theblinkingman/plant-waterer/README.md

# plant-waterer
TDR sensor to water a plant automatically

See https://hackaday.io/project/193184-tdr-soil-moisture-sensor for more details
