theblinkingman/plant-waterer/plant_waterer/plant_waterer.pdf

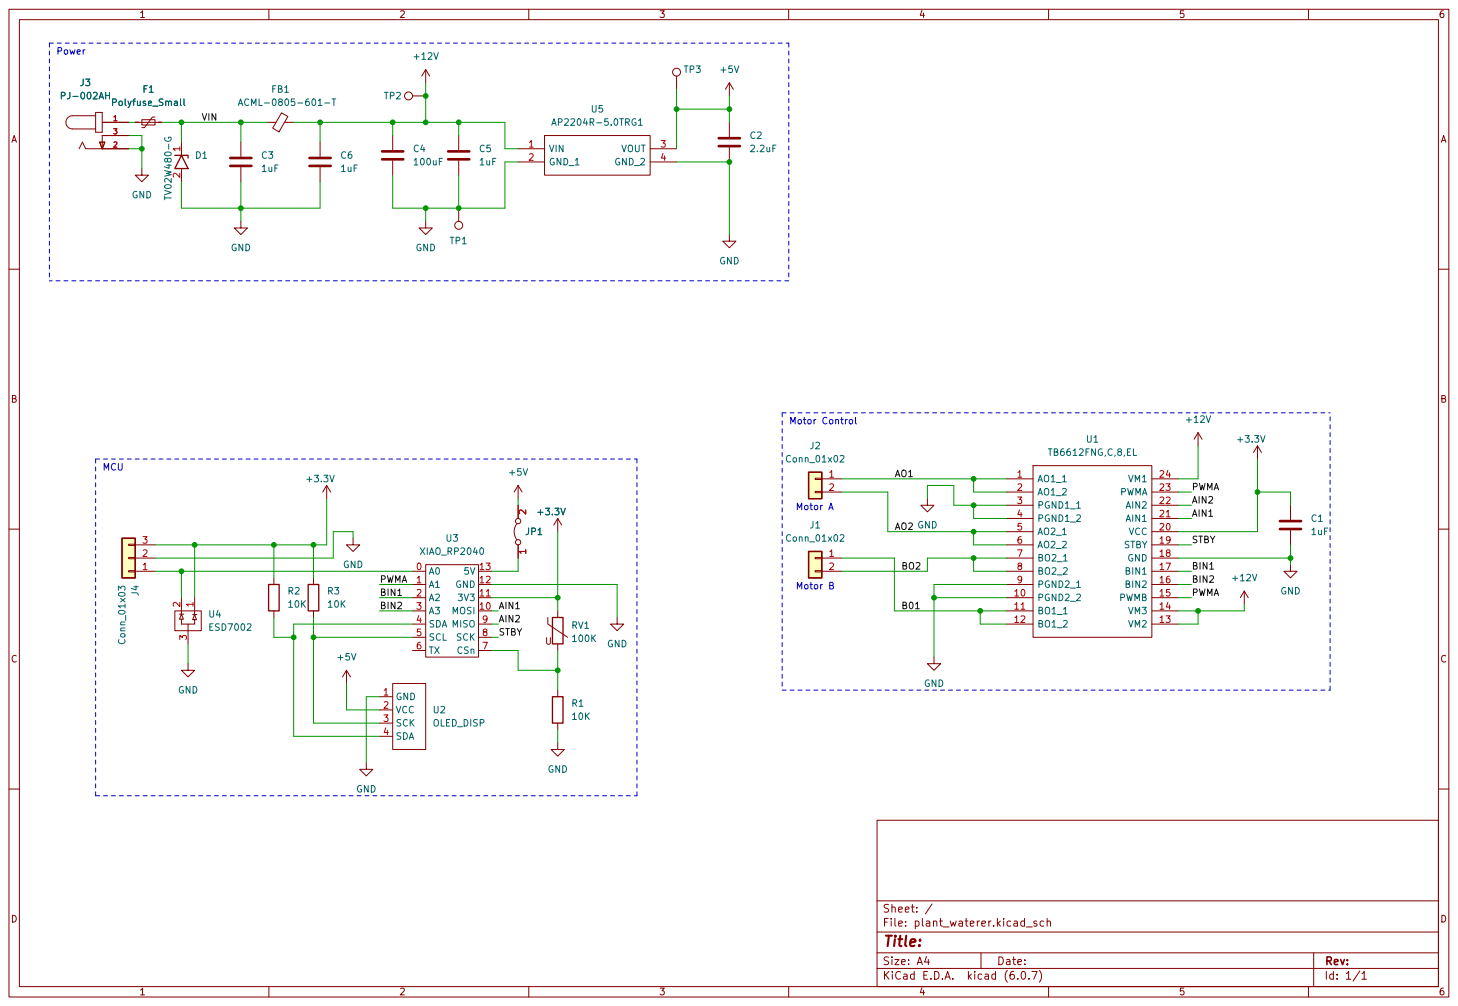
[picture p1: page 1]
