theblinkingman/plant-waterer/plant_combined/plant_combined.kicad_pcb

## KiCad design plant_combined/plant_combined.kicad_pcb (2023-11-19)

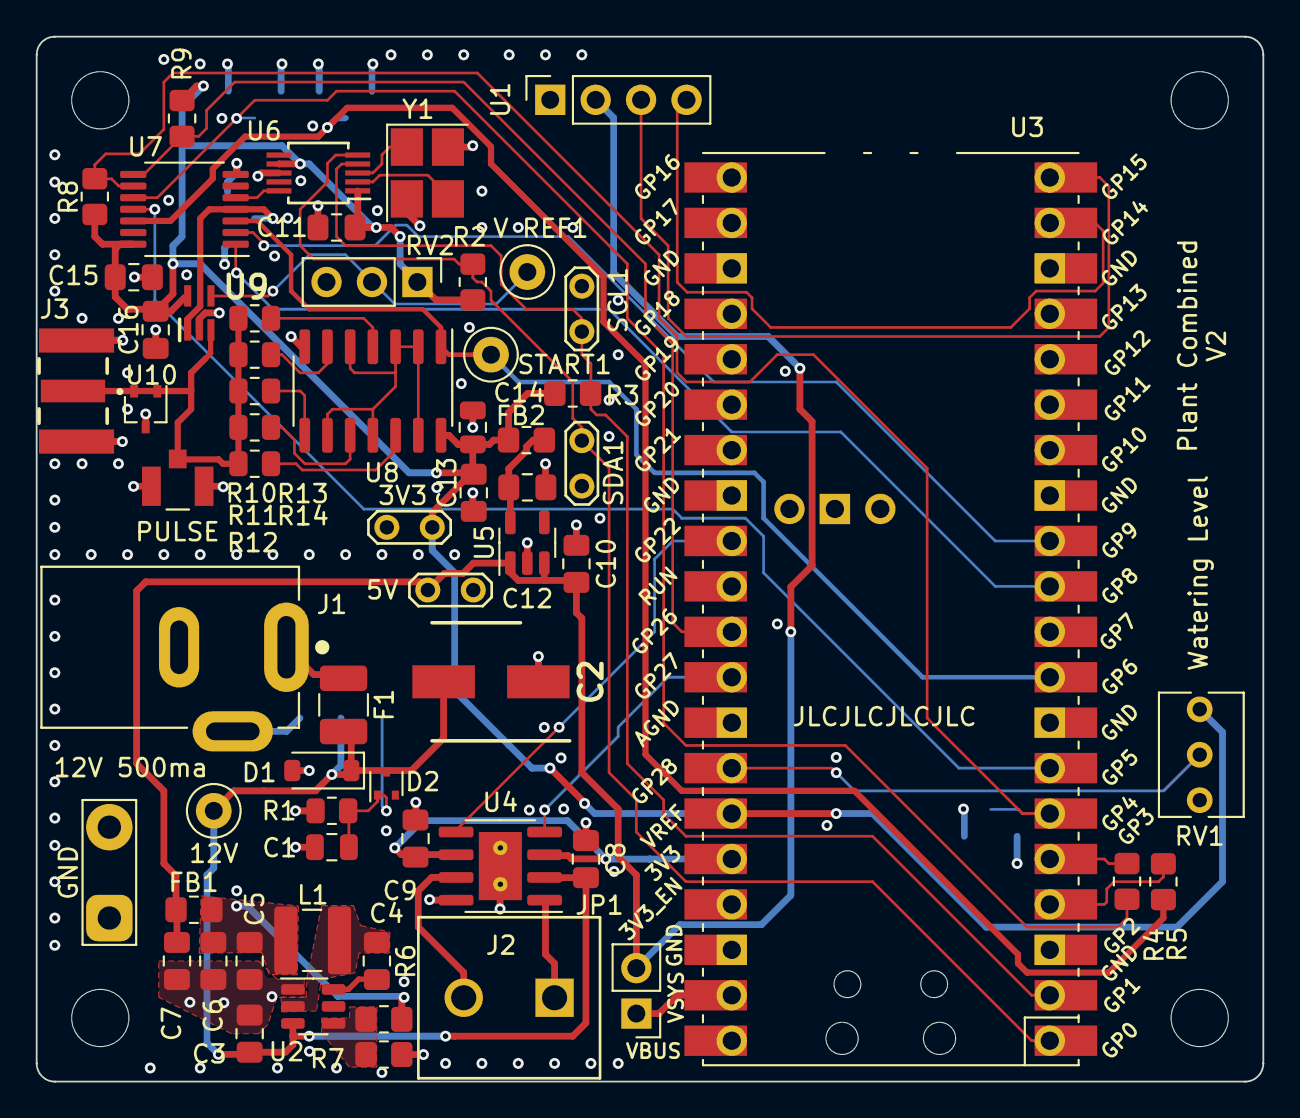
[picture p2: board plant_combined.kicad_pcb from above]

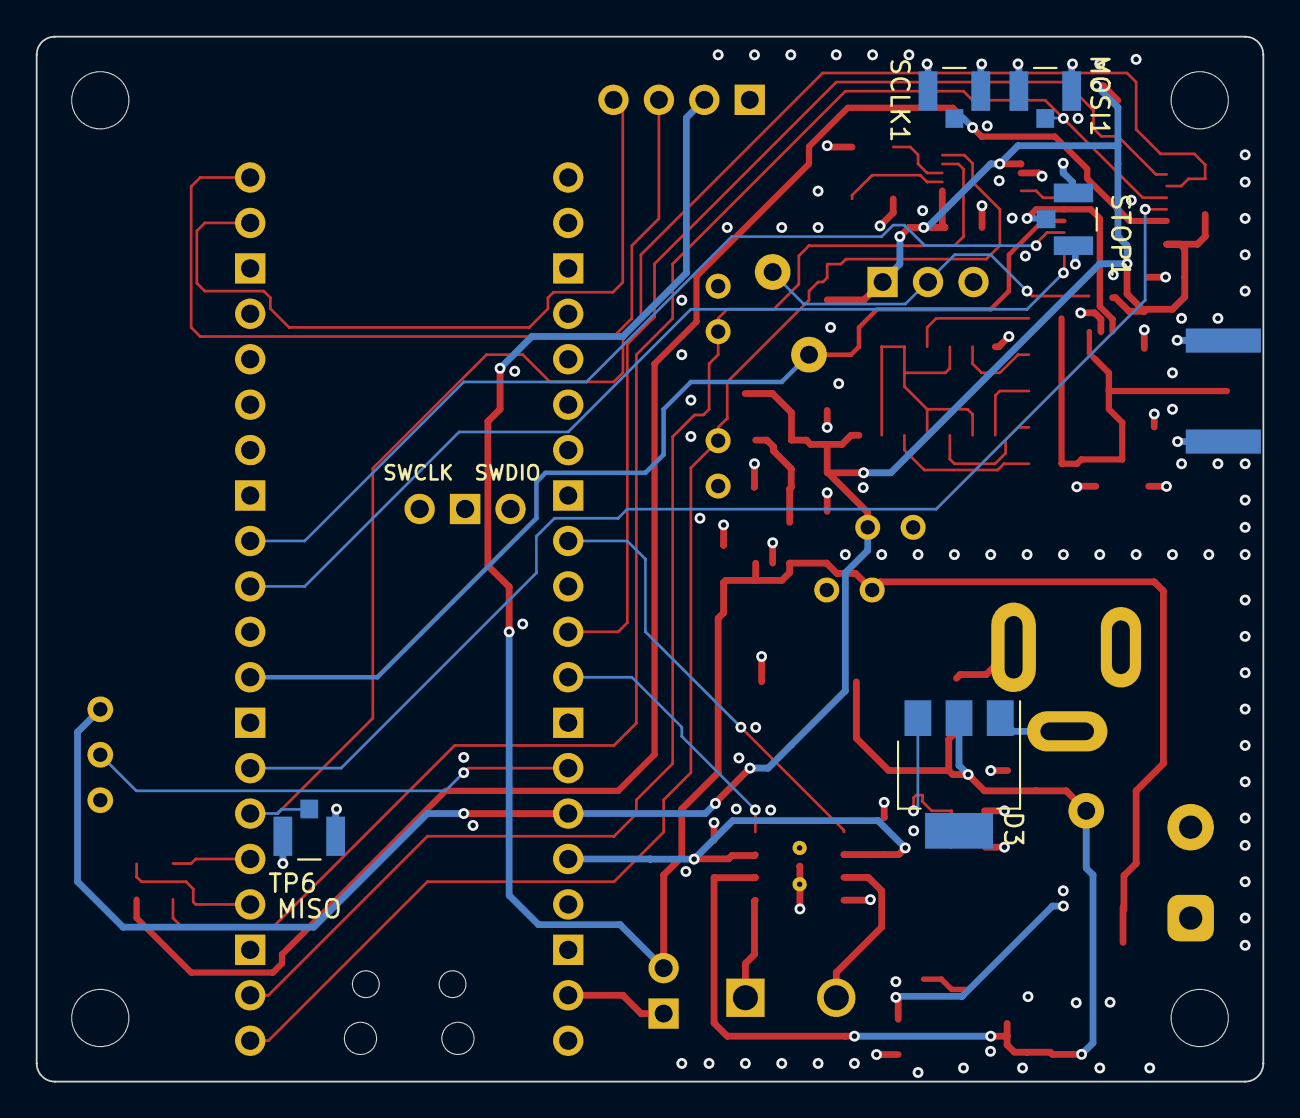
[picture p3: board plant_combined.kicad_pcb from below]

Board: 4 copper layers, 68.6 x 58.4 mm, 67 parts (5 on the bottom side), 44 nets.

Parts:
C1: 10nf; C_0805_2012Metric
C2: 100uF; UUA1C101MCL1GS
C3, C8: 10uF; C_0805_2012Metric_Pad1.18x1.45mm_HandSolder
C4: 100nF; C_0805_2012Metric_Pad1.18x1.45mm_HandSolder
C5: 22uF; C_0805_2012Metric_Pad1.18x1.45mm_HandSolder
C6, C7, C9, C10, C11, C12, C13, C15, C16: 1uF; C_0805_2012Metric_Pad1.18x1.45mm_HandSolder
C14: 1uF; C_0805_2012Metric
D1: TV02W480-G; D_SOD-123
D2: BZX84Cxx; SOT-523
D3: BT168GW; SOT-223
F1: 500ma; Fuse_1210_3225Metric_Pad1.42x2.65mm_HandSolder
FB1, FB2: ACML-0805-601-T; R_0805_2012Metric_Pad1.20x1.40mm_HandSolder
J1: PJ-002AH; CUI_PJ-002AH
J2: Conn_01x02; CONN 1x2 5mm
J3: SMA-J-P-H-ST-EM1; SAMTEC_SMA-J-P-H-ST-EM1
JP1: Jumper_2_Bridged; PinHeader_1x02_P2.54mm_Vertical
L1: 4.7uH; SDCL1V4020
MOSI1: TestPoint; HIROSE_U.FL-R-SMT-1(01)
R1: 68; R_0805_2012Metric
R2, R3: 4K7; R_0805_2012Metric_Pad1.20x1.40mm_HandSolder
R4, R5: 82; R_0805_2012Metric_Pad1.20x1.40mm_HandSolder
R6: 52K3; R_0805_2012Metric_Pad1.20x1.40mm_HandSolder
R7, R9: 10K; R_0805_2012Metric_Pad1.20x1.40mm_HandSolder
R8: 1K; R_0805_2012Metric_Pad1.20x1.40mm_HandSolder
R10, R11, R12, R13, R14: 249; R_0805_2012Metric
RV1: R_Potentiometer; Potentiometer_Bourns_3266Y_Vertical
RV2: 10K; PinHeader_1x03_P2.54mm_Vertical
SCL1: TestPoint_2Pole; TestPoint_2Pads_Pitch2.54mm_Drill1mm
SCLK1: TestPoint; HIROSE_U.FL-R-SMT-1(01)
SDA1: TestPoint_2Pole; TestPoint_2Pads_Pitch2.54mm_Drill1mm
START1: TestPoint; TestPoint_Loop_D1.80mm_Drill1.0mm_Beaded
STOP1: TestPoint; HIROSE_U.FL-R-SMT-1(01)
TP1: TestPoint; TestPoint_Loop_D1.80mm_Drill1.0mm_Beaded
TP1#2, TP6: TestPoint; HIROSE_U.FL-R-SMT-1(01)
TP2: TestPoint_2Pole; TestPoint_2Pads_Pitch5.08mm_Drill1.3mm
TP3: TestPoint; TestPoint_2Pads_Pitch2.54mm_Drill1mm
TP4: TestPoint_2Pole; TestPoint_2Pads_Pitch2.54mm_Drill1mm
U1: OLED_DISP; PinSocket_1x04_P2.54mm_Vertical
U2: AP62200WU-7; SOT-23-6
U3: PicoW; RPi_PicoW_SMD_TH
U4: ZXBM5210-SP-13; SOIC-8-1EP_3.9x4.9mm_P1.27mm_EP2.41x3.81mm
U5: MCP1700T; TSOT-23-5
U6: SI5351A-B-GT; MSOP-10_3x3mm_P0.5mm
U7: TDC7200PWR; TSSOP-14_4.4x5mm_P0.65mm
U8: 74AC14SC; SOIC-14_3.9x8.7mm_P1.27mm
U9: ADCMP600BKSZ-R2; SOT65P210X110-5N
U10: ESD7002; SOT-323_SC-70
V REF1: TestPoint; TestPoint_Loop_D1.80mm_Drill1.0mm_Beaded
Y1: Crystal_GND24; Crystal_SMD_3225-4Pin_3.2x2.5mm_HandSoldering

Connections:
+3.3V: C9.2, U3.36 (3V3), U4.3 (VDD), U4.6 (VREF)
+3.3VA: C11.2, C13.2, C14.1, C15.2, C16.2, FB2.2, R2.1, R3.1, R8.2, R9.2, RV1.1, RV2.1, TP4.2, U3.35 (ADC_VREF), U6.1 (VDD), U6.7 (VDDO), U7.14 (VDD), U8.14 (VCC), U9.5 (VCC_I/O)
+5V: C7.2, C10.2, FB1.2, JP1.2 (B), TP3.2, U1.2 (VCC), U5.1 (IN), U5.3 (EN)
+12P: C2.2, C3.2, C8.2, D1.1, D2.3 (K), D3.2 (A), F1.2, TP1.1, U2.3 (VIN), U4.2 (VM)
/5V_JUMP: JP1.1 (A), U3.39 (VSYS)
/5V_UNFILT: C5.2, C6.2, FB1.1, L1.2, R6.1
/AIN1: U3.32 (GPIO27_ADC1), U4.4 (FWD)
/AIN2: U3.29 (GPIO22), U4.5 (REV)
/AO1: J2.1, U4.1 (OUT_1)
/AO2: J2.2, U4.7 (OUT_2)
/FB: R6.2, R7.1, U2.4 (FB)
/SW: C4.1, L1.1, U2.2 (SW)
/VIN: F1.1, J1.1
/tdr_sensor/+3_UNFILTERED: C12.2, FB2.1, U5.5 (OUT)
/tdr_sensor/CLK: U6.10 (CLK0), U7.5 (CLOCK)
/tdr_sensor/PULSE: J3.1, R10.2, R11.2, R12.2, R13.2, R14.2, TP1#2.1, U9.3 (VP), U10.1, U10.2
/tdr_sensor/STOP: STOP1.1, U7.4 (STOP), U9.1 (Q)
/tdr_sensor/V ref: RV2.2, U9.4 (VN), V REF1.1
EN: U3.11 (GPIO8), U7.1 (ENABLE)
GND: C1.2, C2.1, C3.1, C5.1, C6.1, C7.1, C8.1, C9.1, C10.1, C11.1, C12.1, C13.1, C14.2, C15.1, C16.1, D1.2, D3.1 (K), J1.2, J1.3, J3.2_1, J3.2_2, J3.3_1, J3.3_2, MOSI1.2, R1.1, R7.2, RV1.3, RV2.3, SCL1.2, SCLK1.2, SDA1.1, STOP1.2, TP1#2.2, TP2.1, TP2.2, TP3.1, TP4.1, TP6.2, U1.1 (GND), U2.1 (GND), U3.3 (GND), U3.8 (GND), U3.13 (GND), U3.18 (GND), U3.23 (GND), U3.28 (GND), U3.33 (AGND), U3.38 (GND), U4.8 (GND), U4.9 (EP), U5.2 (GND), U6.8 (GND), U7.7 (GND), U8.7 (GND), U9.2 (GND), U10.3, Y1.2, Y1.4
INTB: R9.1, U3.31 (GPIO26_ADC0), U7.8 (INTB)
MISO: R8.1, TP6.1, U3.6 (GPIO4), U7.9 (DOUT)
MOSI: MOSI1.1, R4.2, U7.10 (DIN)
unnamed: C1.1, D2.1 (A), D3.3 (G), R1.2
unnamed: U1.3 (SCK), U3.20 (GPIO15)
unnamed: U1.4 (SDA), U3.19 (GPIO14)
unnamed: C4.2, U2.6 (BST)
unnamed: R5.1, U3.4 (GPIO2)
unnamed: R4.1, U3.5 (GPIO3)
unnamed: RV1.2, U3.34 (GPIO28_ADC2)
unnamed: U6.2 (XA), Y1.3
unnamed: U6.3 (XB), Y1.1
unnamed: U8.2 (O0), U8.3 (I1), U8.5 (I2), U8.9 (I3), U8.11 (I4), U8.13 (I5)
unnamed: R10.1, U8.4 (O1)
unnamed: R11.1, U8.6 (O2)
unnamed: R12.1, U8.8 (O3)
unnamed: R13.1, U8.10 (O4)
unnamed: R14.1, U8.12 (O5)
SCL: R3.2, SCL1.1, U3.2 (GPIO1), U6.4 (SCL)
SCLK: R5.2, SCLK1.1, U7.12 (SCLK)
SDA: R2.2, SDA1.2, U3.1 (GPIO0), U6.5 (SDA)
START: START1.1, U3.9 (GPIO6), U7.3 (START), U8.1 (I0)
TDC CSB: U3.7 (GPIO5), U7.11 (CSB)
TRIG: U3.12 (GPIO9), U7.2 (TRIGG)
