theblinkingman/plant-waterer/plant_waterer/plant_waterer.kicad_pcb

## KiCad design plant_waterer/plant_waterer.kicad_pcb (2023-04-02)

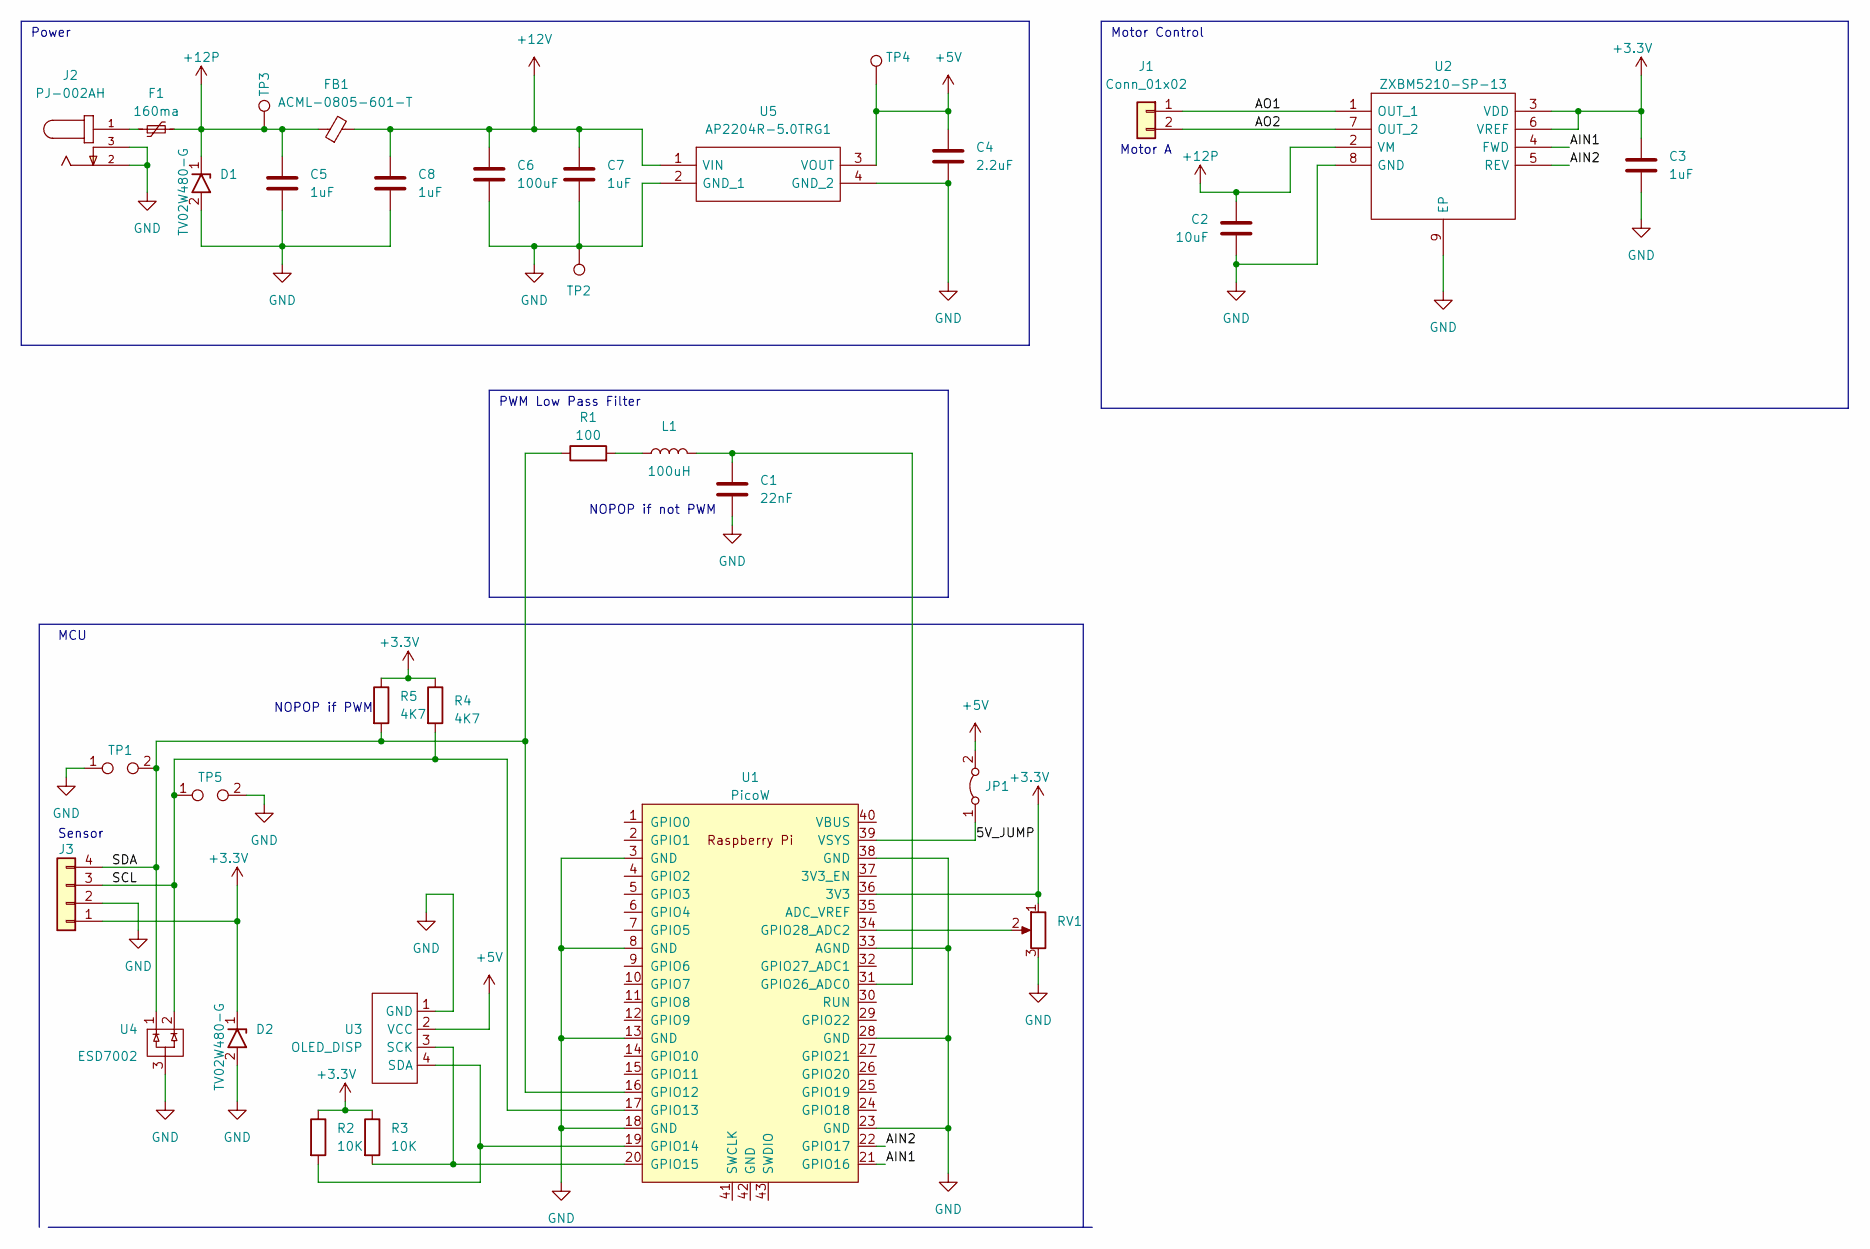
[picture p4: schematic plant_waterer.kicad_sch]

Parts:
C1: 22nF; C_0805_2012Metric_Pad1.18x1.45mm_HandSolder
C2: 10uF; C_0805_2012Metric_Pad1.18x1.45mm_HandSolder
C3, C5, C7, C8: 1uF; C_0805_2012Metric_Pad1.18x1.45mm_HandSolder
C4: 2.2uF; C_0805_2012Metric_Pad1.18x1.45mm_HandSolder
C6: 100uF; UUA1C101MCL1GS
D1, D2: TV02W480-G; D_SOD-123
F1: 160ma; Fuse_1210_3225Metric_Pad1.42x2.65mm_HandSolder
FB1: ACML-0805-601-T; R_0805_2012Metric_Pad1.20x1.40mm_HandSolder
J1: Conn_01x02; CONN 1x2 5mm
J2: PJ-002AH; CUI_PJ-002AH
J3: Conn_01x03; PinSocket_1x04_P2.54mm_Vertical
JP1: Jumper_2_Bridged; PinHeader_1x02_P2.54mm_Vertical
L1: 100uH; L_0805_2012Metric_Pad1.05x1.20mm_HandSolder
R1: 100; R_0805_2012Metric_Pad1.20x1.40mm_HandSolder
R2, R3: 10K; R_0805_2012Metric_Pad1.20x1.40mm_HandSolder
R4, R5: 4K7; R_0805_2012Metric_Pad1.20x1.40mm_HandSolder
RV1: R_Potentiometer; Potentiometer_Bourns_3266Y_Vertical
TP1, TP5: TestPoint_2Pole; TestPoint_2Pads_Pitch5.08mm_Drill1.3mm
TP2: TestPoint; TestPoint_2Pads_Pitch5.08mm_Drill1.3mm
TP3, TP4: TestPoint; TestPoint_Loop_D1.80mm_Drill1.0mm_Beaded
U1: PicoW; RPi_PicoW_SMD_TH
U2: ZXBM5210-SP-13; SOIC-8-1EP_3.9x4.9mm_P1.27mm_EP2.41x3.81mm; Manufacturer_Part_Number ZXBM5210-SP-13; Mouser Part Number 621-ZXBM5210-SP-13
U3: OLED_DISP; PinSocket_1x04_P2.54mm_Vertical
U4: ESD7002; SOT-323_SC-70
U5: AP2204R-5.0TRG1; AP2204R50TRG1; Manufacturer_Part_Number AP2204R-5.0TRG1; Mouser Part Number 621-AP2204R-5.0TRG1

Connections:
+3.3V: C3.2, D2.1, J3.1, R2.1, R3.1, R4.1, R5.1, RV1.1, U1.36 (3V3), U2.3 (VDD), U2.6 (VREF)
+5V: C4.2, JP1.2 (B), TP4.1, U3.2 (VCC), U5.3 (VOUT)
+12P: C2.2, C5.2, D1.1, F1.2, FB1.1, TP3.1, U2.2 (VM)
+12V: C6.2, C7.2, C8.2, FB1.2, U5.1 (VIN)
/5V_JUMP: JP1.1 (A), U1.39 (VSYS)
/AIN1: U1.21 (GPIO16), U2.4 (FWD)
/AIN2: U1.22 (GPIO17), U2.5 (REV)
/AO1: J1.1, U2.1 (OUT_1)
/AO2: J1.2, U2.7 (OUT_2)
/SCL: J3.3, R4.2, TP5.1, U1.17 (GPIO13), U4.2
/SDA: J3.4, R1.1, R5.2, TP1.2, U1.16 (GPIO12), U4.1
GND: C1.1, C2.1, C3.1, C4.1, C5.1, C6.1, C7.1, C8.1, D1.2, D2.2, J2.2, J2.3, J3.2, RV1.3, TP1.1, TP2.1, TP5.2, U1.3 (GND), U1.8 (GND), U1.13 (GND), U1.18 (GND), U1.23 (GND), U1.28 (GND), U1.33 (AGND), U1.38 (GND), U2.8 (GND), U2.9 (EP), U3.1 (GND), U4.3, U5.2 (GND_1), U5.4 (GND_2)
unnamed: F1.1, J2.1
unnamed: L1.1, R1.2
unnamed: R2.2, U1.19 (GPIO14), U3.4 (SDA)
unnamed: R3.2, U1.20 (GPIO15), U3.3 (SCK)
unnamed: C1.2, L1.2, U1.31 (GPIO26_ADC0)
unnamed: RV1.2, U1.34 (GPIO28_ADC2)

Notes on the sheet:
Sensor
Motor Control
MCU
Power
NOPOP if not PWM
PWM Low Pass Filter
Motor A
NOPOP if PWM

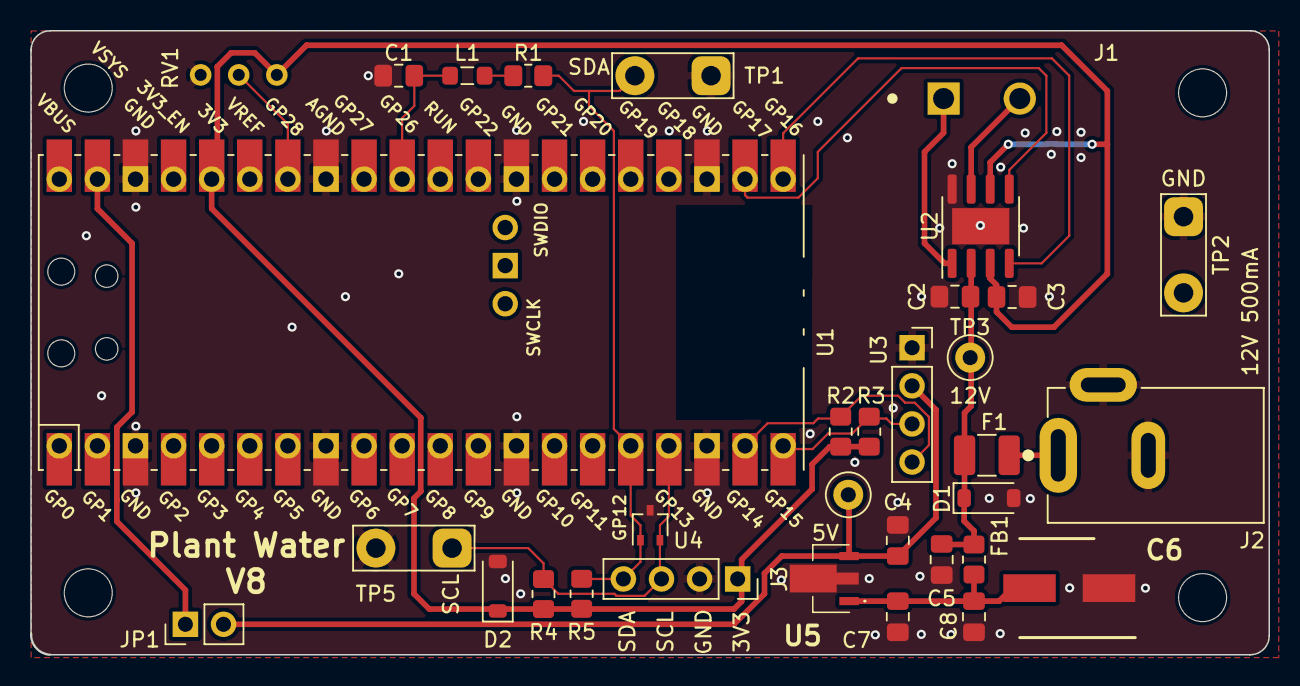
[picture p5: board plant_waterer.kicad_pcb from above]

Board: 2 copper layers, 82.5 x 41.6 mm, 33 parts (0 on the bottom side), 18 nets.
