theblinkingman/plant-waterer/(commit log)

2022-10-18 Totally custom board
    [plant_waterer.kicad_pcb, plant_waterer.kicad_sch]
2022-11-12 Added UART input Added second motor output Added fuse and reverse polarity protection
    [plant_waterer.kicad_pcb, plant_waterer.kicad_sch]
2022-11-12 Updated version to latest
    [plant_waterer.kicad_pcb]
2022-12-09 Display sensor reading every 10 secs and don't bother with datetime anymore
2022-12-10 Add adjustable level set Add power filtering Add ESD
    [plant_waterer.kicad_pcb, plant_waterer.kicad_sch]
2022-12-11 Minor clean up and adding schmatic
    [plant_waterer.kicad_pcb, plant_waterer.kicad_sch]
2023-01-12 Code update for set pot and V7 bodge
    [code.py]
2023-01-12 Switched pot to ADC pin
    [plant_waterer.kicad_pcb, plant_waterer.kicad_sch]
2023-02-20 V7 pre-switch to RPi-Pico
    [plant_waterer.kicad_pcb, plant_waterer.kicad_sch]
2023-02-21 Swapped in RPi Pico W
    [plant_waterer.kicad_pcb, plant_waterer.kicad_sch]
2023-02-21 Switched to different motor driver ZXBM5210-SP-13
    [plant_waterer.kicad_pcb, plant_waterer.kicad_sch]
2023-03-06 Switch code to Pico W and add wifi
2023-03-06 Added off board connectors for I2C
    [plant_waterer.kicad_pcb, plant_waterer.kicad_sch]
2023-03-06 Cleanup for V5
    [plant_waterer.kicad_pcb, plant_waterer.kicad_sch]
2023-03-17 Combined board of both sensor and motor controller
    [plant_combined.kicad_pcb, plant_combined.kicad_sch, tdr_sensor.kicad_sch]
2023-04-02 Code updated to work with combined board
2023-04-02 Fixes for footprints
    [plant_combined.kicad_pcb, plant_combined.kicad_sch, plant_waterer.kicad_pcb, tdr_sensor.kicad_sch]
2023-04-11 Add indicator for recent waterings Fix first watering check
    [code.py]
2023-04-12 Added HTTP server with sensor readings Added watchdog
2023-05-08 First attempt to shrink board
    [plant_combined.kicad_pcb, plant_combined.kicad_sch]
2023-05-17 Adding code to handle when the interrupt is missed
    [code.py]
2023-05-17 Trying to clean up pulse trace
    [plant_combined.kicad_pcb]
2023-06-04 Final tweak before release
    [plant_combined.kicad_pcb, plant_combined.kicad_sch]
2023-11-19 Add pull-up to MISO
    [plant_combined.kicad_pcb, plant_combined.kicad_sch, tdr_sensor.kicad_sch]
2023-11-20 Update code to use faster SPI clock
    20M SPI clock
    Enabled watchdog
    Disabled WiFi
    Removed extra lib
